lrj1197/Thesis/Notes/Notes_1_15_19.txt

Prototype 2 was completed today. 
was unable to test. 
thermoetry is at the top exterior of the cryostat and the 4L dewar was used to house the LN2

Coldfinger 1.2 test:
	->
