lrj1197/Thesis/Paper/URC/Paper.docx

Background and Introduction

Sum up Poltarg and why we need Pol targs

Describe the freezing process, past, present and future

State why this new freezing process is better

Setup and procedural outline

How to make the material and why this way

Go through the setup of the gas panel and what's necessary for it to work

Analysis of results

Density

Quantitative discussion

Conclusion and further work

More controlled way of freezing

Temperature?

Solidify more material?
