lrj1197/Thesis/Document/Ammonia_PD.jpg

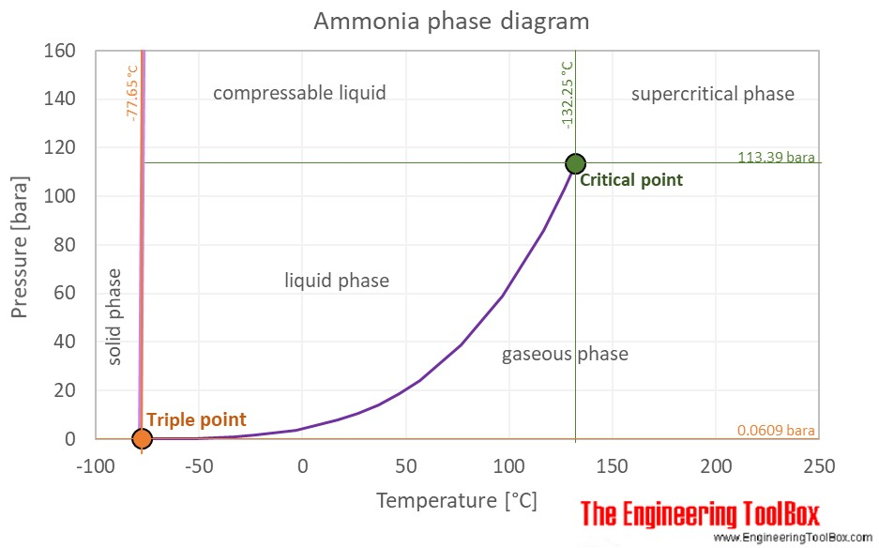
Document/Ammonia_PD.jpg
