lrj1197/Thesis/Document/mirf-new.jpg

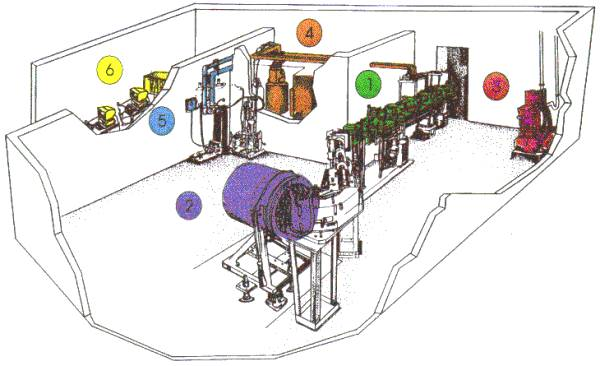
Document/mirf-new.jpg
