lrj1197/Thesis/Document/N_PD.jpeg

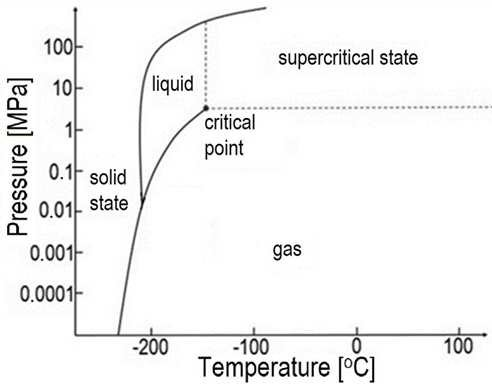
Document/N_PD.jpeg
