lrj1197/Thesis/Document/Scatter.png

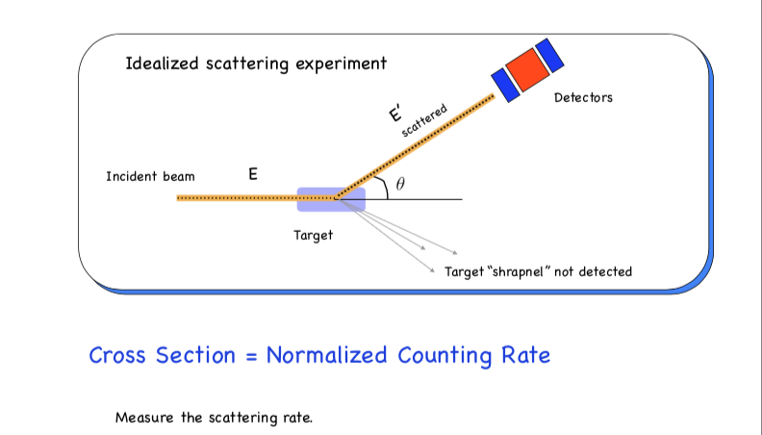
Document/Scatter.png
