lrj1197/Thesis/Paper/URC/CSTAT.png

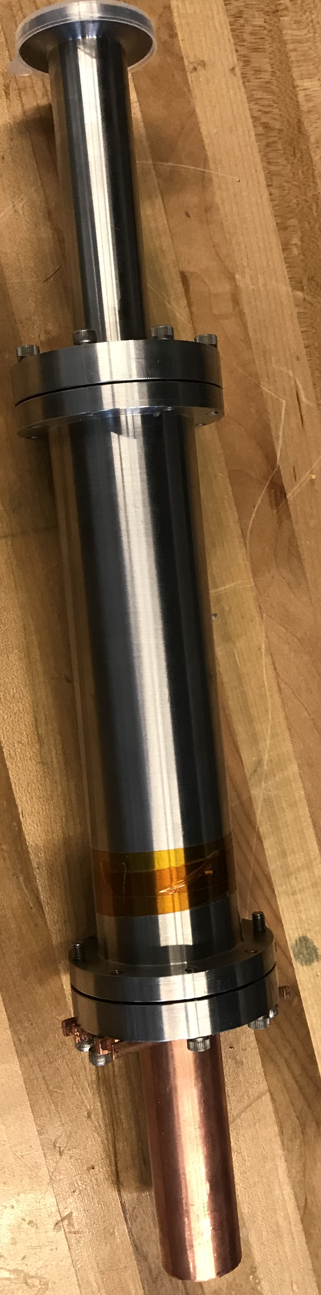
Paper/URC/CSTAT.png
