lrj1197/Thesis/Paper/URC/Flow_NH3.jpg

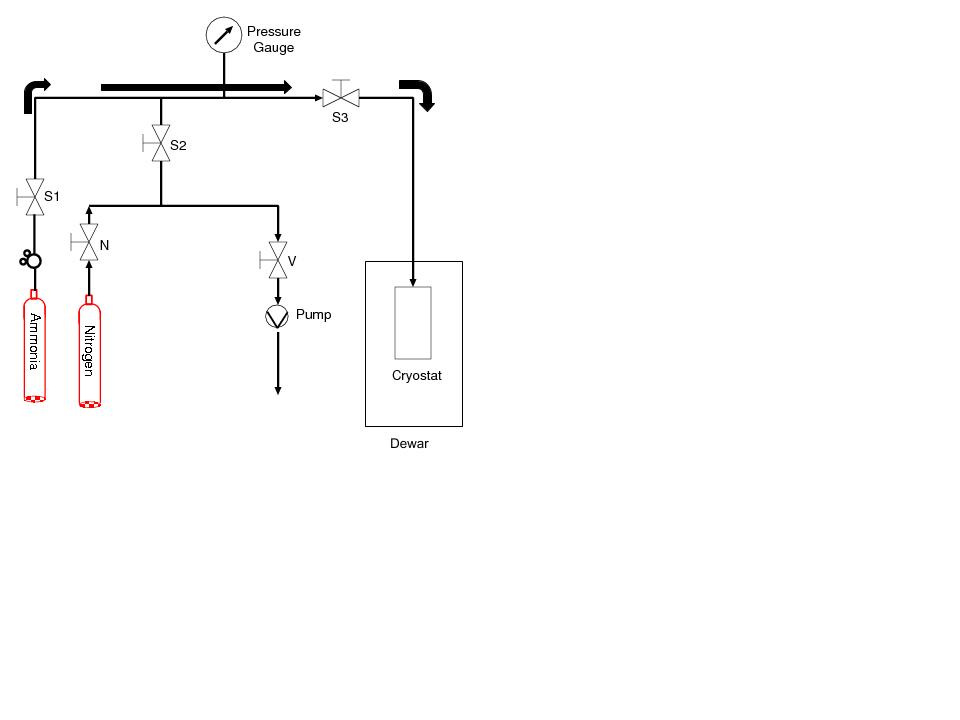
Paper/URC/Flow_NH3.jpg
