lrj1197/Thesis/Paper/URC/freezing_app.jpg

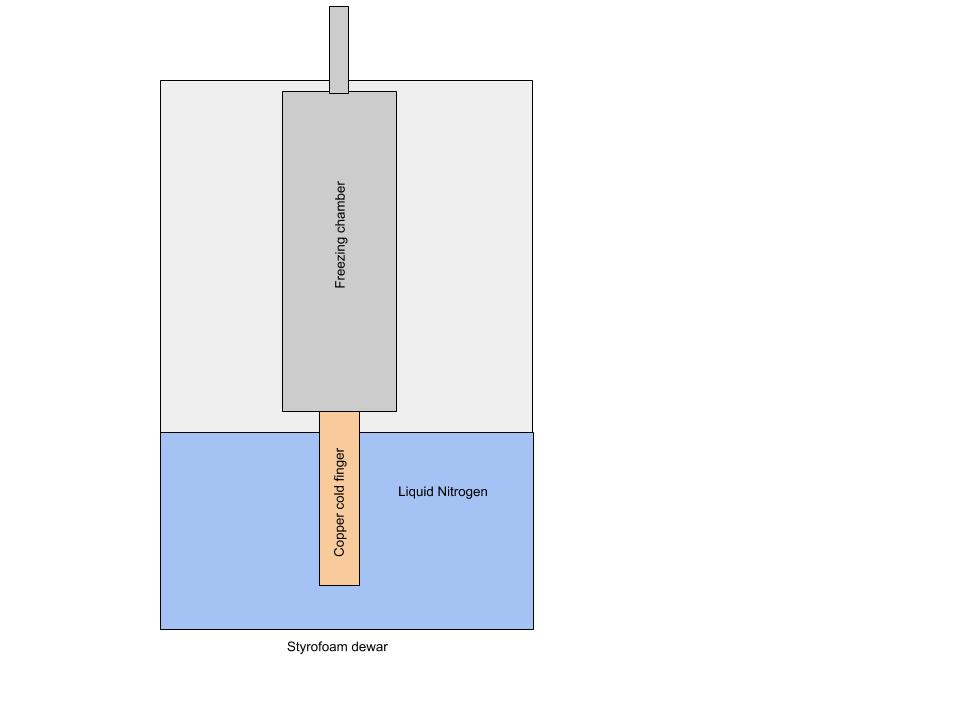
Paper/URC/freezing_app.jpg
