lrj1197/Thesis/Paper/URC/IMG_1883.jpg

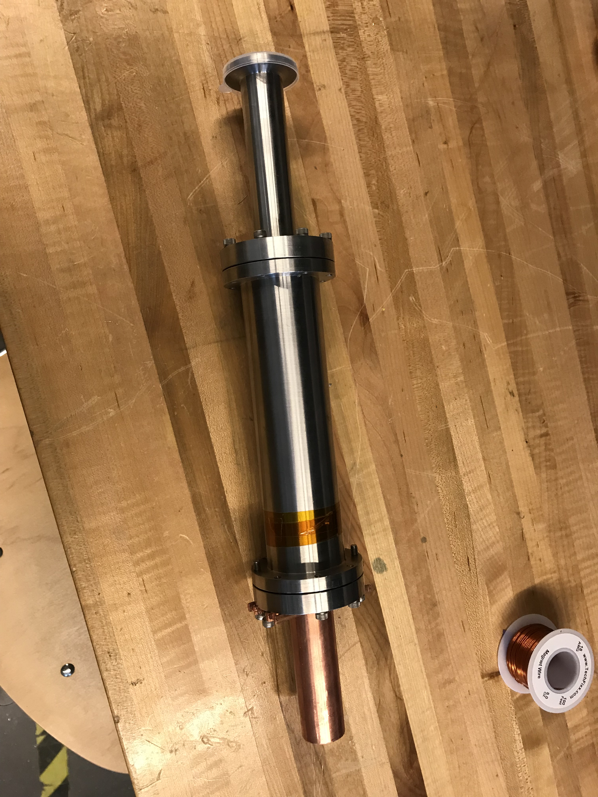
Paper/URC/IMG_1883.jpg
