lrj1197/Thesis/Paper/URC/IMG_1960.jpg

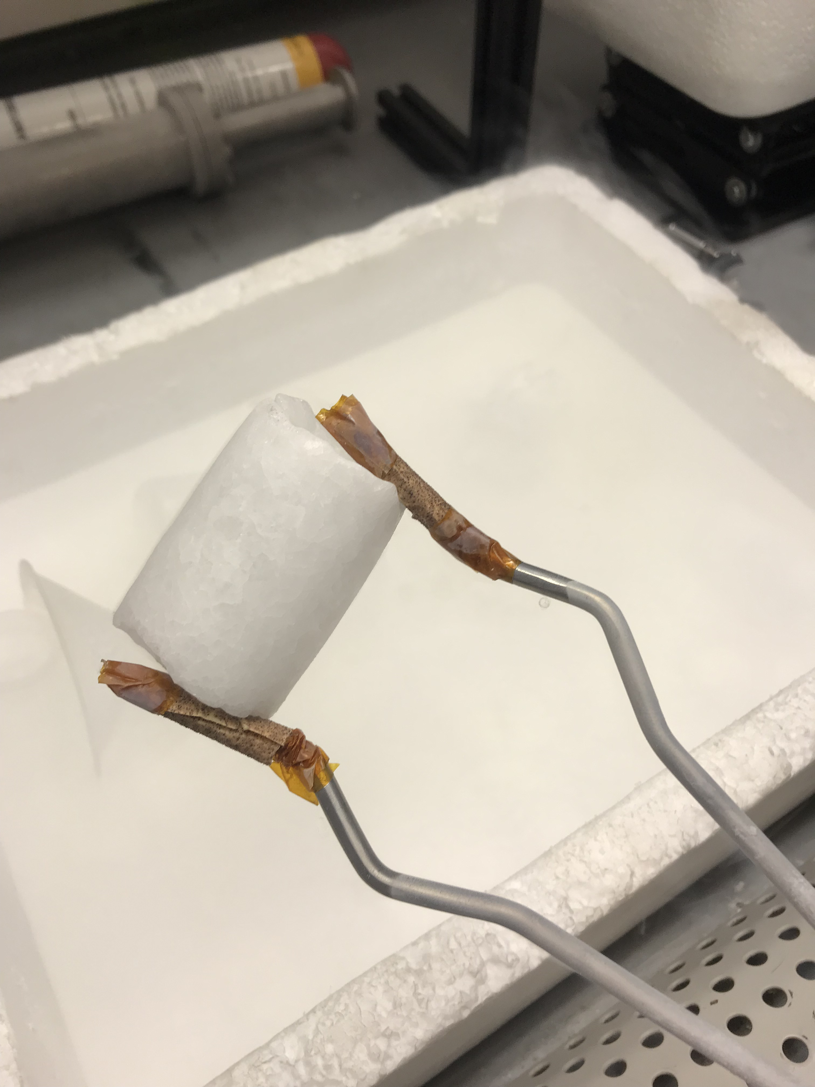
Paper/URC/IMG_1960.jpg
