lrj1197/Thesis/Paper/URC/Untitled drawing(1).jpg

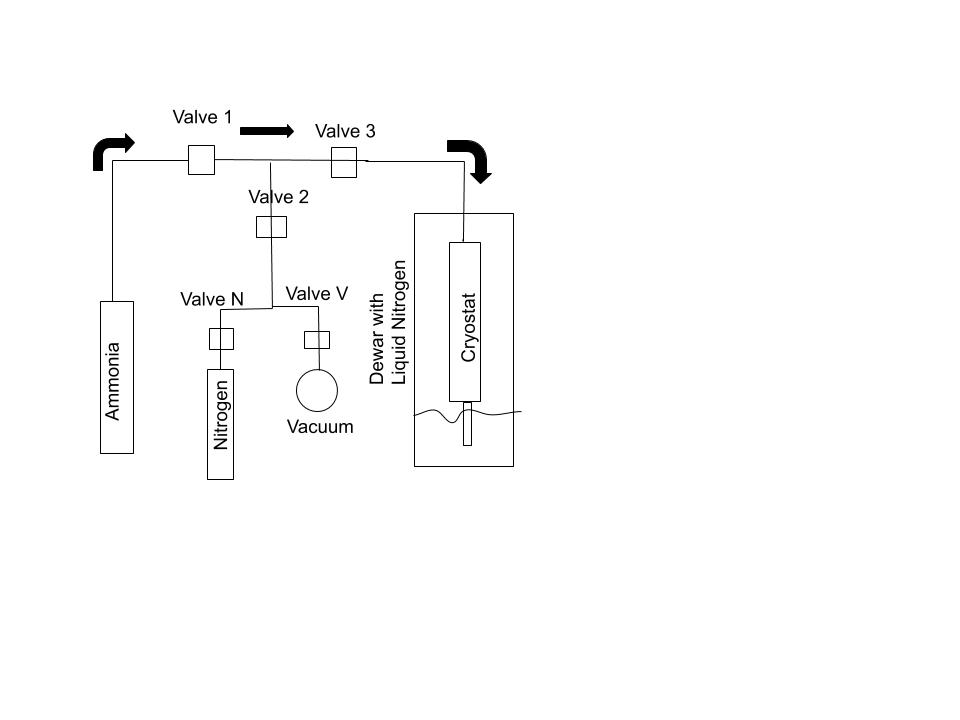
Paper/URC/Untitled drawing(1).jpg
