lrj1197/Thesis/Paper/URC/Untitled drawing.jpg

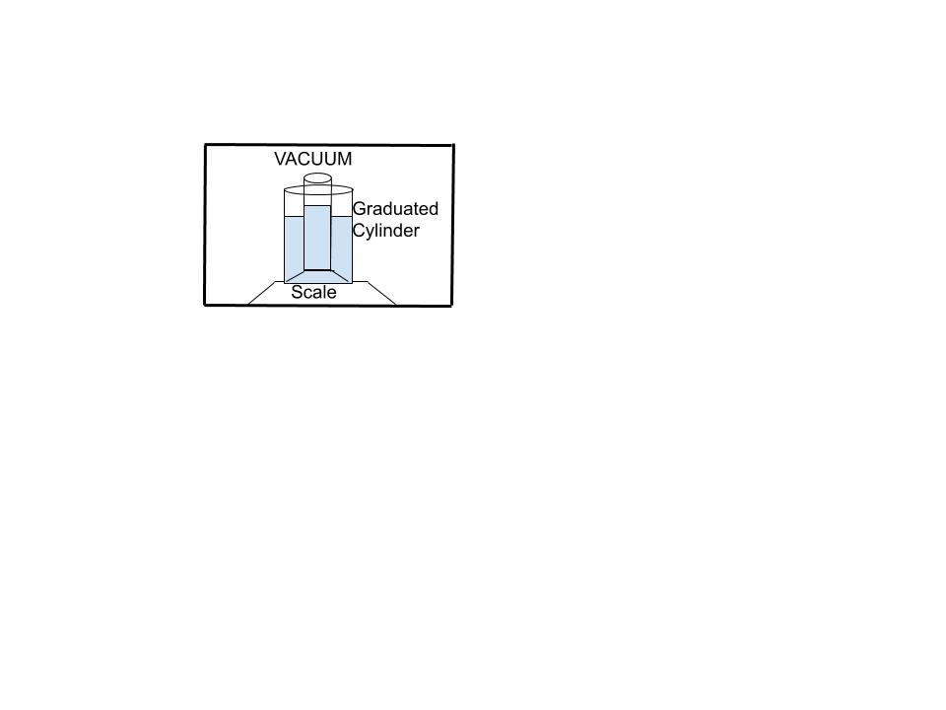
Paper/URC/Untitled drawing.jpg
