lrj1197/Thesis/Photos/IMG_1689.jpg

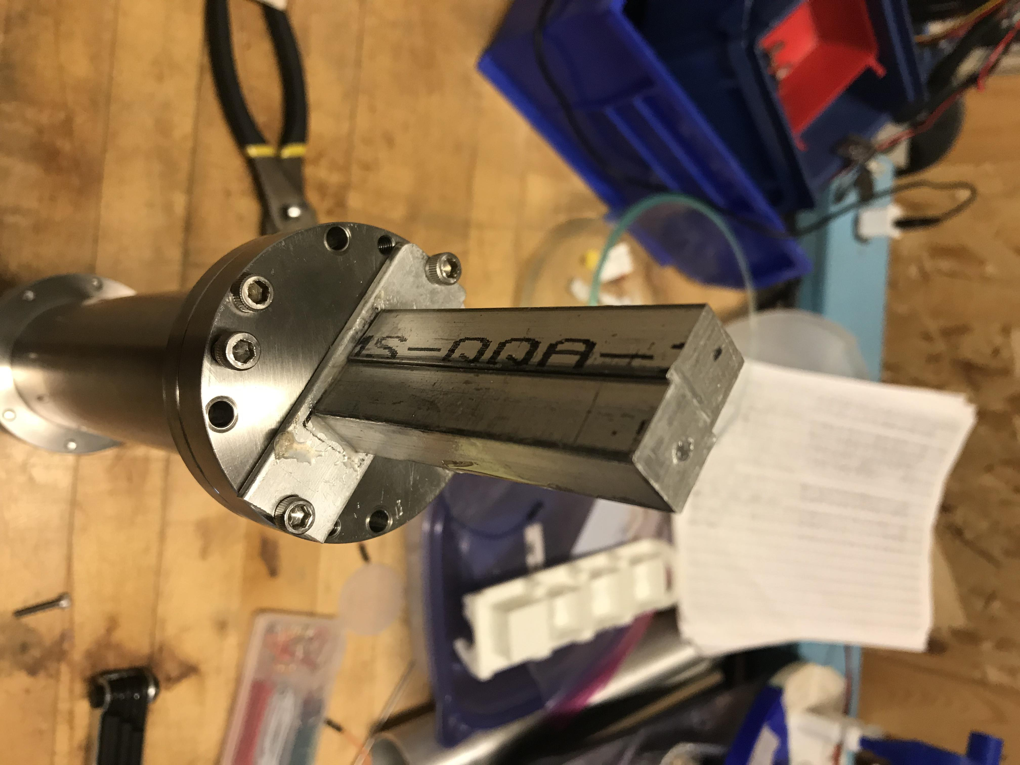
Photos/IMG_1689.jpg
