lrj1197/Thesis/Photos/IMG_1699.jpg

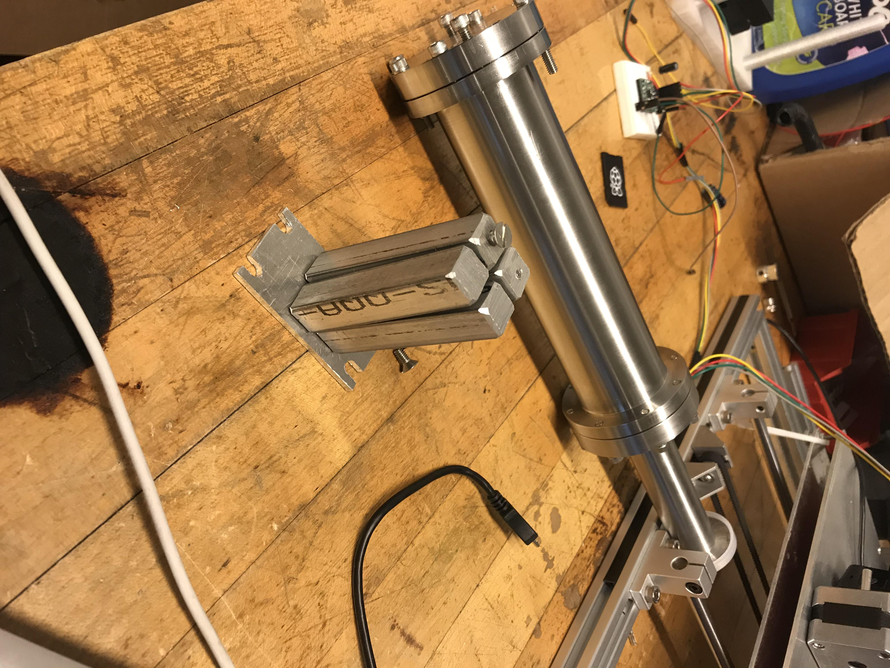
Photos/IMG_1699.jpg
