lrj1197/Thesis/Photos/IMG_1704.jpg

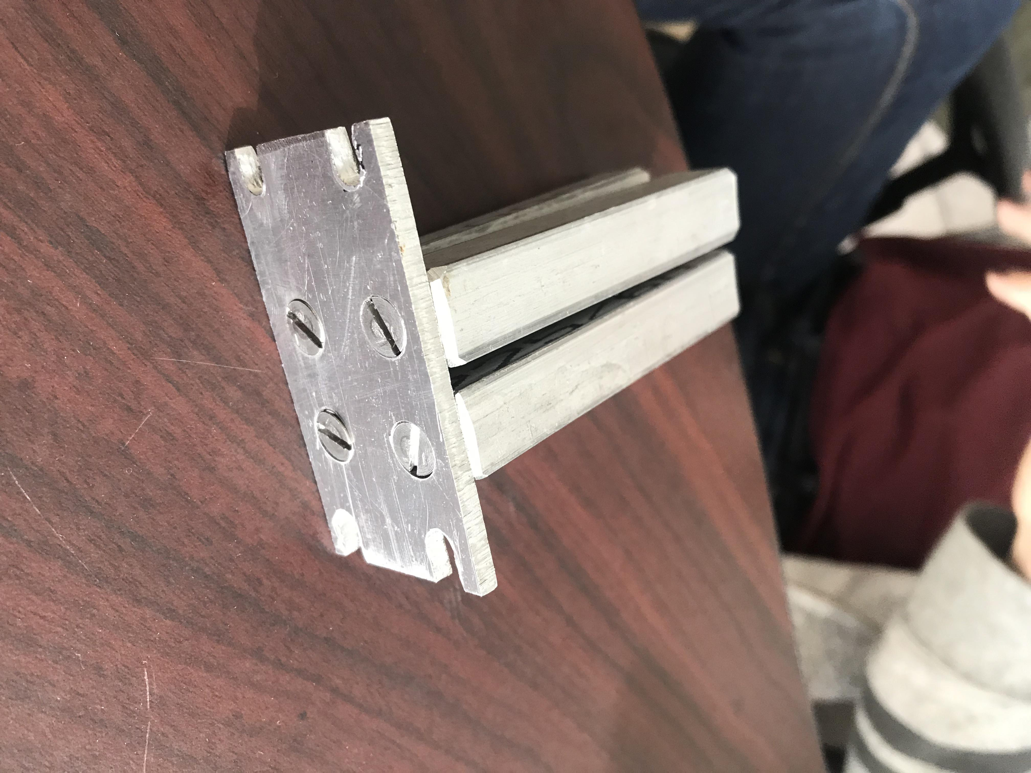
Photos/IMG_1704.jpg
