lrj1197/Thesis/Photos/IMG_1705.jpg

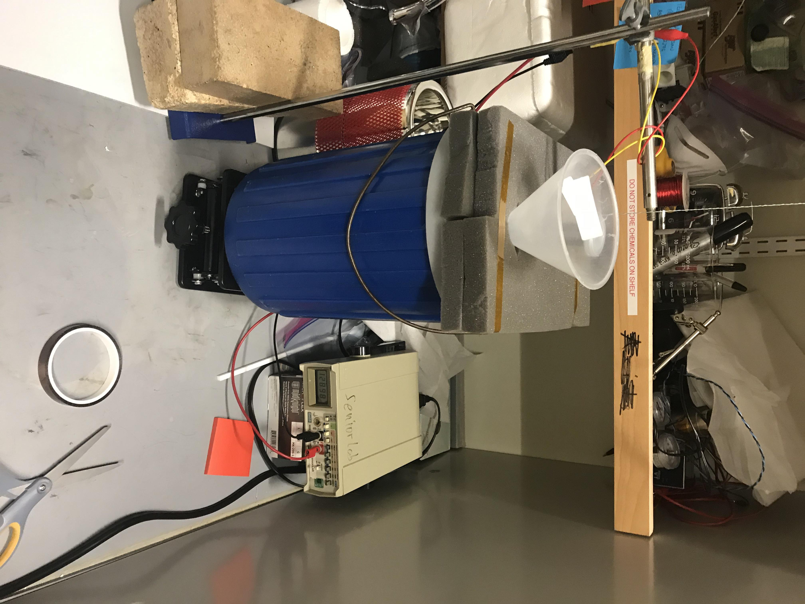
Photos/IMG_1705.jpg
