lrj1197/Thesis/Photos/IMG_1737.jpg

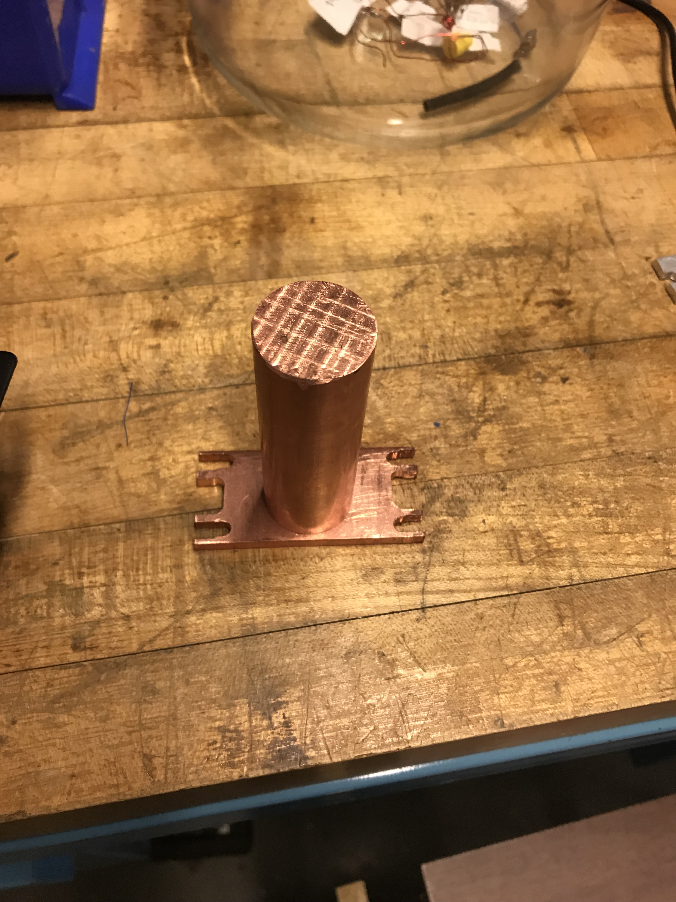
Photos/IMG_1737.jpg
